ene-h/PE2/Production_Files/PE2BOM.xls

Comment | Designator | Footprint
C2977719 miniUSBb | J1 | PE2:JLC_MINI-USB-SMD
C3008585 bootselSW | U1 | PE2:JLC_SW-SMD
STM32F446RCT6 | U3 | PE2:STM32F446RCT6
DM-OLED096-636 | U4 | PE2:MODULE_DM-OLED096-636
C603505 NCP115ASN330T2G LDO | U2 | PE2:SOT95P275X110-5N
100n | C1 C4 C6 C7 C8 C9 C11 C16 | Capacitor_SMD:C_0402_1005Metric
1uF | C2 C10 | Capacitor_SMD:C_0603_1608Metric
1uF Cer | C3 C12 | Capacitor_SMD:C_0603_1608Metric
10uF | C5 | Capacitor_SMD:C_0603_1608Metric
C382724 33pF | C13 C14 | Capacitor_SMD:C_0402_1005Metric
4.7uF | C15 | Capacitor_SMD:C_0603_1608Metric
C2286 PWR | D1 | LED_SMD:LED_0603_1608Metric
C2286 USR | D2 | LED_SMD:LED_0603_1608Metric
Conn_01x06 | J2 | Connector_PinHeader_2.54mm:PinHeader_1x06_P2.54mm_Horizontal
Conn_01x05 | J4 | Connector_PinHeader_2.54mm:PinHeader_1x05_P2.54mm_Horizontal
C163810 10k | R1 R2 | Resistor_SMD:R_0402_1005Metric
C226821 180R | R3 R4 | Resistor_SMD:R_0402_1005Metric
C455091 | SW1 SW5 SW9 SW11 SW15 SW19 | Button_Switch_THT:SW_PUSH_6mm_H5mm
SW_Push | SW2 SW3 SW4 SW6 SW7 SW8 SW12 SW13 SW14 SW16 SW17 SW18 | Kailh:Kailh_socket_PG1350_optional
C2985742 | SW10 | PE2:JLC_TactSW_Low-profile
C115962 8MHz | Y1 | Crystal:Crystal_SMD_5032-2Pin_5.0x3.2mm
