ene-h/PE2/Case_3D_Files/PCB-final.step

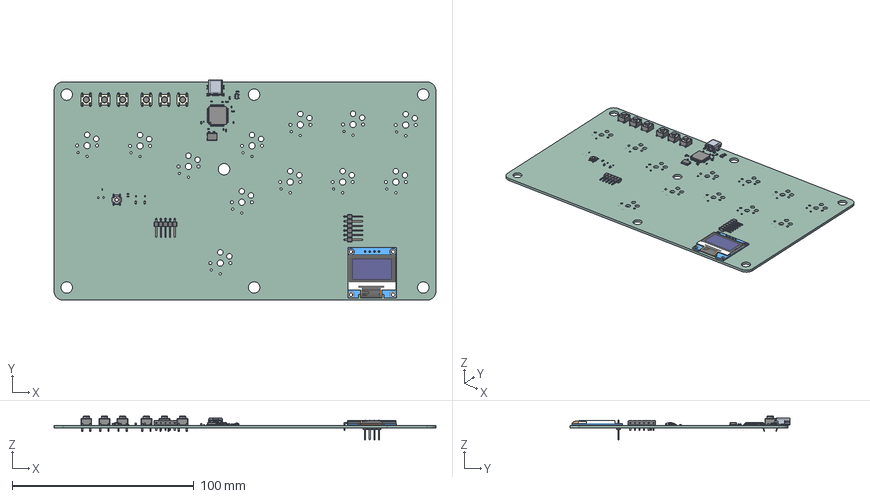
[picture p6: CAD file, 2024-06-01]
Case_3D_Files/PCB-final.step
210.0 x 121.2 x 13.1 mm
C_0402_1005Metric x 10
User Library-128x64I2COLEDDisplayAdafruit
LED_0603_1608Metric x 2
NCP551SN15T1G
C_0603_1608Metric x 6
R_0402_1005Metric x 4
PinHeader_1x06_P254mm_Horizontal
TS-1187A-B-A-B
STM32G070RBT6
PinHeader_1x05_P254mm_Horizontal
PE2-for-review_PCB
