ene-h/PE2/KiCad_Project/Componenten/4pos_header_RIGHT_ANGLE/PH1RB-04-UA.STEP

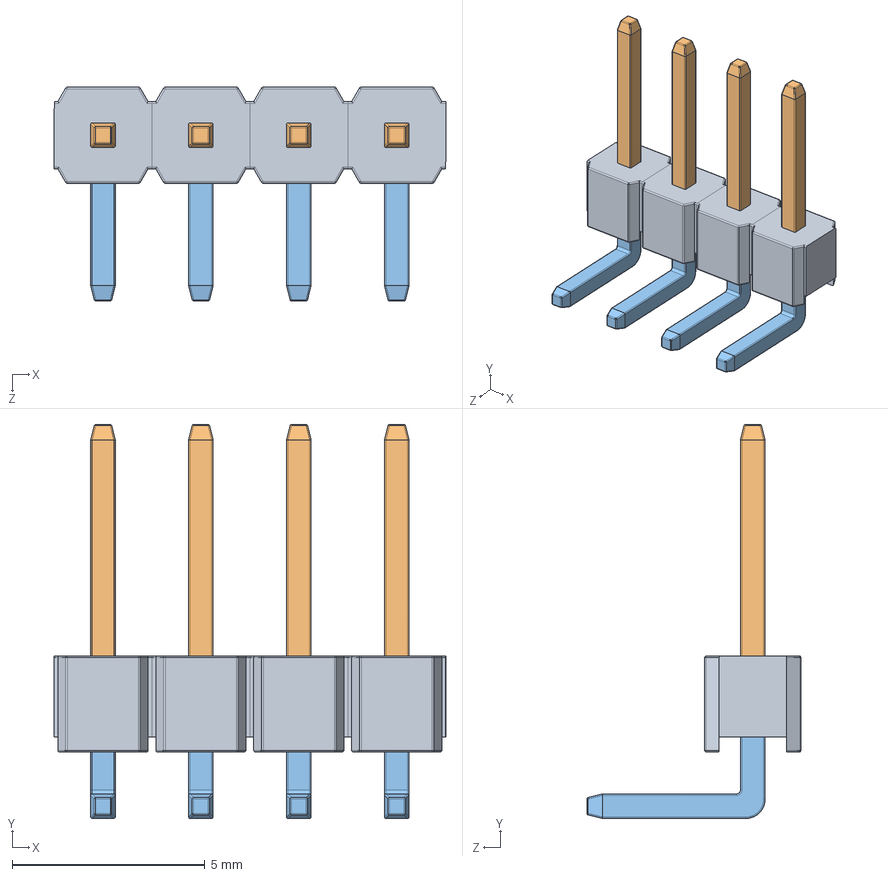
[picture p7: CAD file, 2024-06-01]
KiCad_Project/Componenten/4pos_header_RIGHT_ANGLE/PH1RB-04-UA.STEP
10.2 x 10.2 x 5.55 mm
