ene-h/PE2/KiCad_Project/Componenten/AA_8_000MALV_T/XTAL_AA-8_000MALV-T_TXC.step

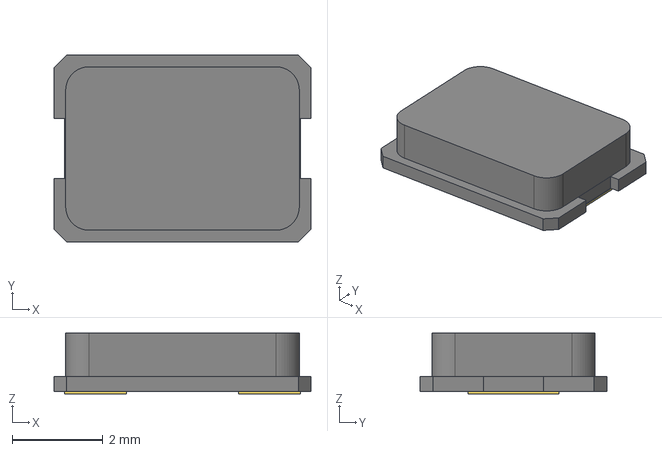
[picture p8: CAD file, 2024-06-01]
KiCad_Project/Componenten/AA_8_000MALV_T/XTAL_AA-8_000MALV-T_TXC.step
5.67 x 4.12 x 1.35 mm
