ene-h/PE2/KiCad_Project/Componenten/Crystal/ECS-80-18-5PX-GM-TR/3D/ECS-80-18-5PX-GM-TR.stp

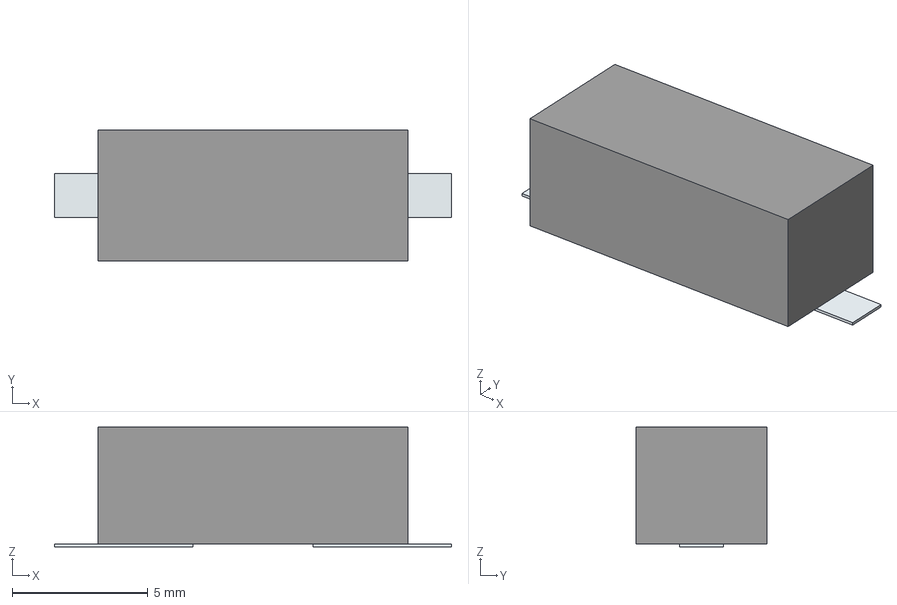
[picture p9: CAD file, 2024-06-01]
KiCad_Project/Componenten/Crystal/ECS-80-18-5PX-GM-TR/3D/ECS-80-18-5PX-GM-TR.stp
14.6 x 4.80 x 4.40 mm
Pins
