ene-h/PE2/KiCad_Project/Componenten/DM-OLED096-636--3DModel-STEP-56544.STEP

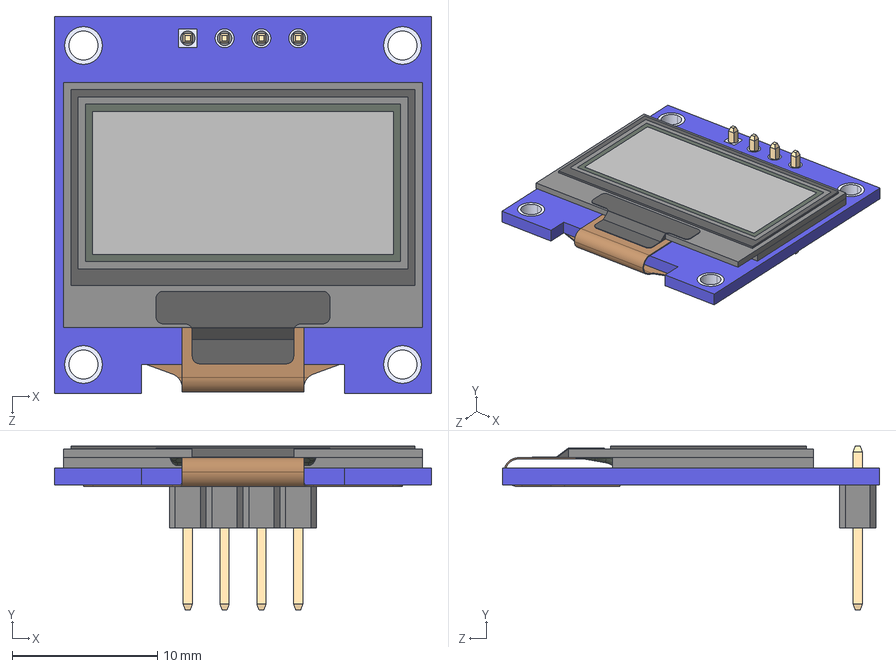
[picture p10: CAD file, 2024-06-01]
KiCad_Project/Componenten/DM-OLED096-636--3DModel-STEP-56544.STEP
26.0 x 11.3 x 26.0 mm
DM-OLED096-636_Module
DM-OLED096-636_Panel
