ene-h/PE2/KiCad_Project/Componenten/DM-OLED096-636/oled-no-header.step

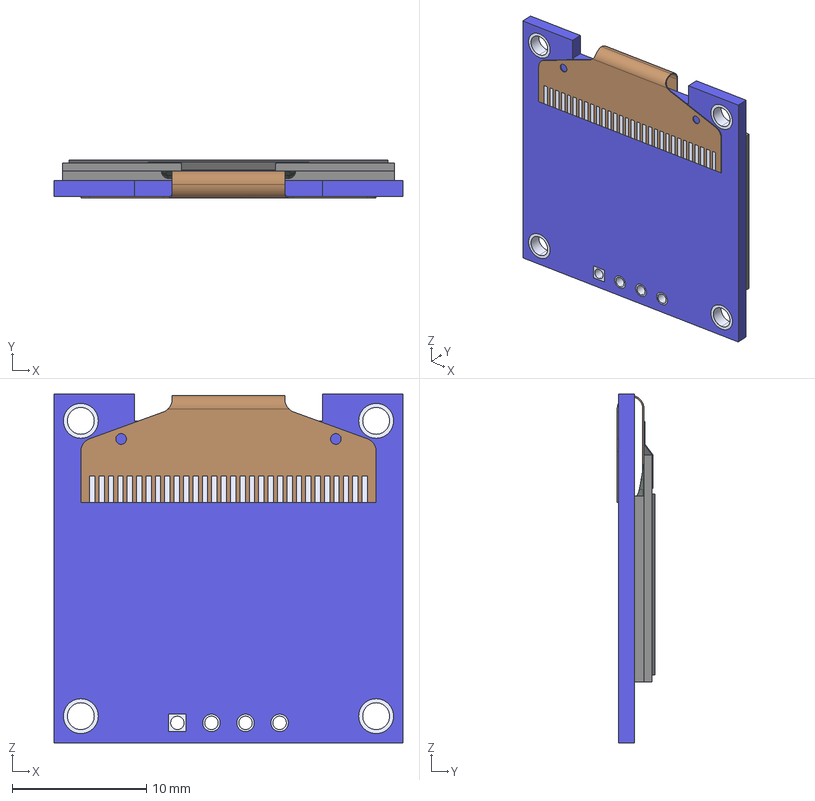
[picture p11: CAD file, 2024-06-01]
KiCad_Project/Componenten/DM-OLED096-636/oled-no-header.step
26.0 x 2.80 x 26.0 mm
DM-OLED096-636_Module009
DM-OLED096-636_Module010
DM-OLED096-636_Module011
DM-OLED096-636_Module012
DM-OLED096-636_Module013
DM-OLED096-636_Module014
DM-OLED096-636_Module015
DM-OLED096-636_Module016
DM-OLED096-636_Module017
DM-OLED096-636_Panel
DM-OLED096-636_Panel001
DM-OLED096-636_Panel002
DM-OLED096-636_Panel003
DM-OLED096-636_Panel004
DM-OLED096-636_Panel005
DM-OLED096-636_Panel006
DM-OLED096-636_Panel007
DM-OLED096-636_Panel008
DM-OLED096-636_Panel009
DM-OLED096-636_Panel010
DM-OLED096-636_Panel011
DM-OLED096-636_Panel012
DM-OLED096-636_Panel013
DM-OLED096-636_Panel014
DM-OLED096-636_Panel015
DM-OLED096-636_Panel016
DM-OLED096-636_Panel017
DM-OLED096-636_Panel018
DM-OLED096-636_Panel019
DM-OLED096-636_Panel020
DM-OLED096-636_Panel021
DM-OLED096-636_Panel022
DM-OLED096-636_Panel023
DM-OLED096-636_Panel024
DM-OLED096-636_Panel025
DM-OLED096-636_Panel026
DM-OLED096-636_Panel027
DM-OLED096-636_Panel028
DM-OLED096-636_Panel029
DM-OLED096-636_Panel030
DM-OLED096-636_Panel031
DM-OLED096-636_Panel032
DM-OLED096-636_Panel033
DM-OLED096-636_Panel034
DM-OLED096-636_Panel035
DM-OLED096-636_Panel036
DM-OLED096-636_Panel037
DM-OLED096-636_Panel038
DM-OLED096-636_Panel039
