ene-h/PE2/KiCad_Project/Componenten/NCP115ASN330T2G/NCP115ASN330T2G.step

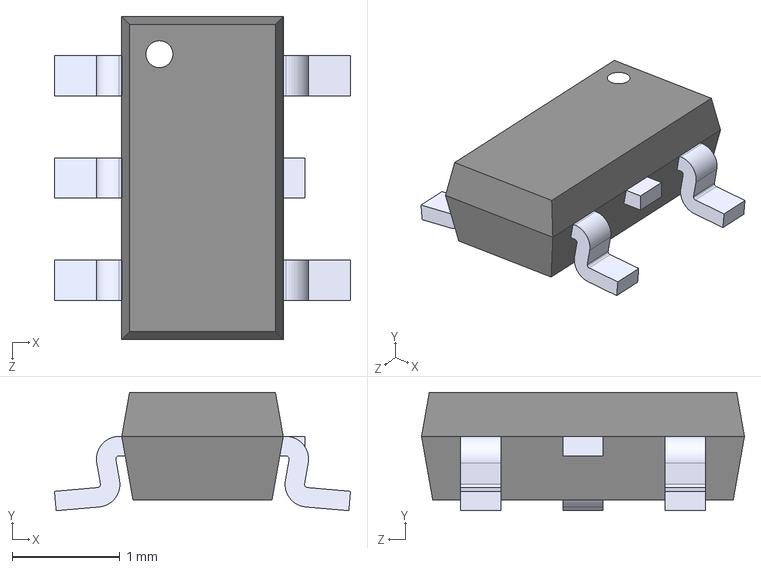
[picture p12: CAD file, 2024-06-01]
KiCad_Project/Componenten/NCP115ASN330T2G/NCP115ASN330T2G.step
2.75 x 1.10 x 3.00 mm
