ene-h/PE2/KiCad_Project/Componenten/STM32F446RCT6/STM32F446RCT6.step

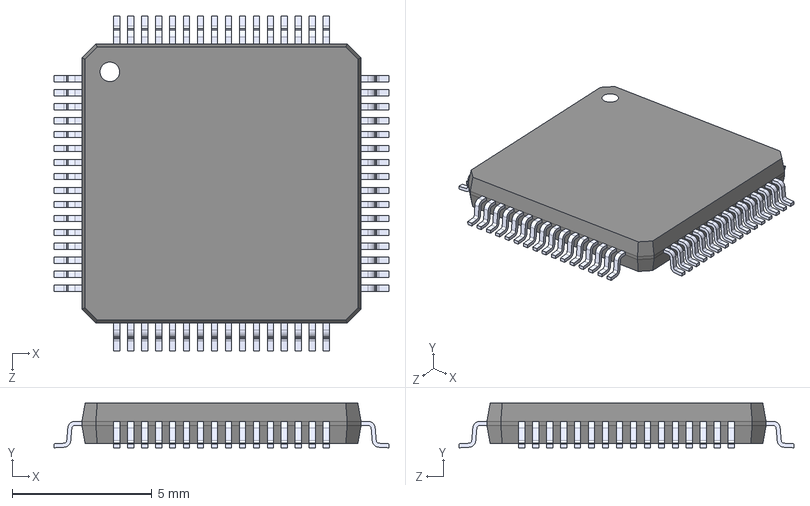
[picture p13: CAD file, 2024-06-01]
KiCad_Project/Componenten/STM32F446RCT6/STM32F446RCT6.step
12.0 x 1.60 x 12.0 mm
