ene-h/PE2/KiCad_Project/Componenten/TS-1187A-B-A-B/TS-1187A-B-A-B.step

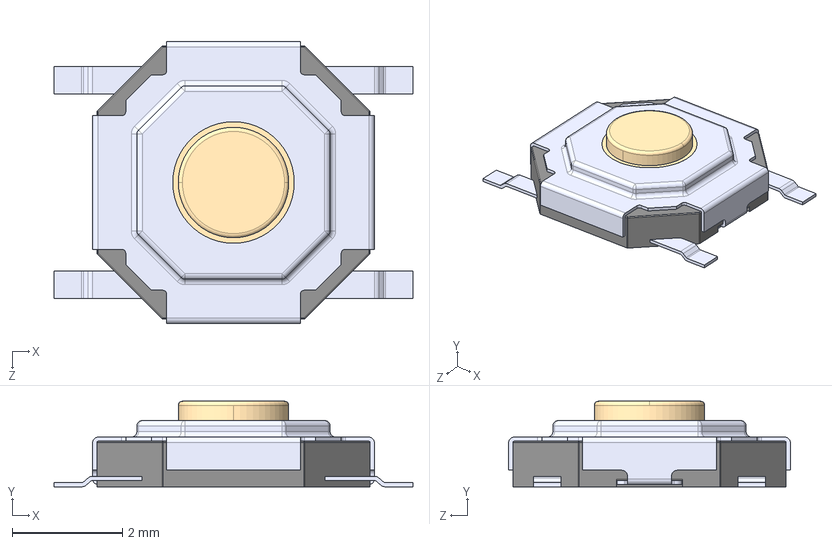
[picture p14: CAD file, 2024-06-01]
KiCad_Project/Componenten/TS-1187A-B-A-B/TS-1187A-B-A-B.step
6.50 x 1.55 x 5.10 mm
