ene-h/PE2/KiCad_Project/Componenten/usbC/USB4125-GF-A_REVA2.step

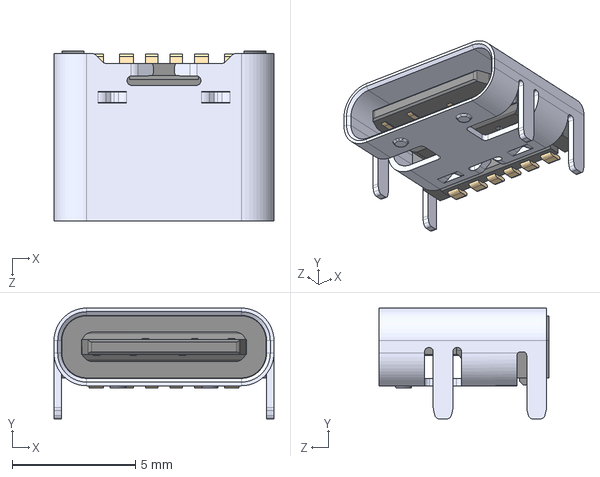
[picture p15: CAD file, 2024-06-01]
KiCad_Project/Componenten/usbC/USB4125-GF-A_REVA2.step
8.94 x 4.51 x 6.90 mm
