ene-h/PE2/KiCad_Project/Componenten/usbM/54-00019.step

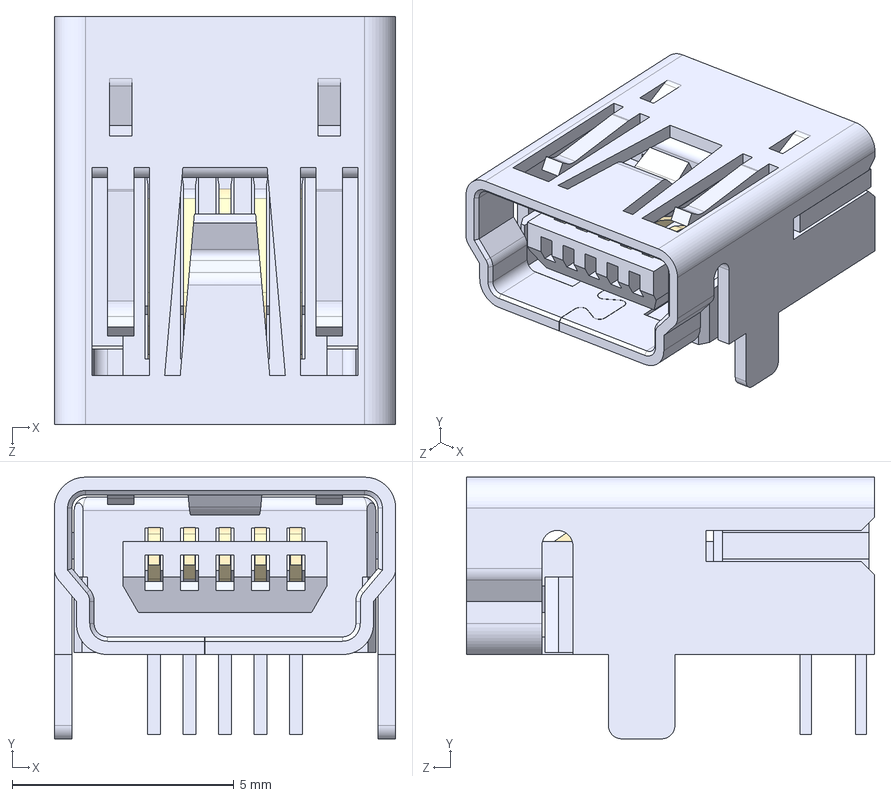
[picture p16: CAD file, 2024-06-01]
KiCad_Project/Componenten/usbM/54-00019.step
7.70 x 5.90 x 9.20 mm
54-00019_shell
54-00019_insulator
54-00019_pin5
54-00019_pin4
54-00019_pin3
54-00019_pin2
54-00019_pin1
