ene-h/PE2/KiCad_Project/Componenten/usbM2/WQ-1600514.stp

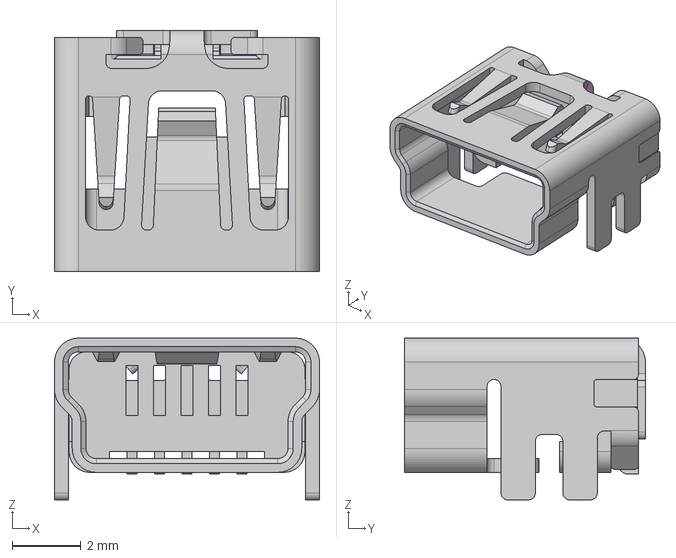
[picture p17: CAD file, 2024-06-01]
KiCad_Project/Componenten/usbM2/WQ-1600514.stp
7.70 x 7.00 x 4.70 mm
