ene-h/PE2/KiCad_Project/PE2-for-review.step

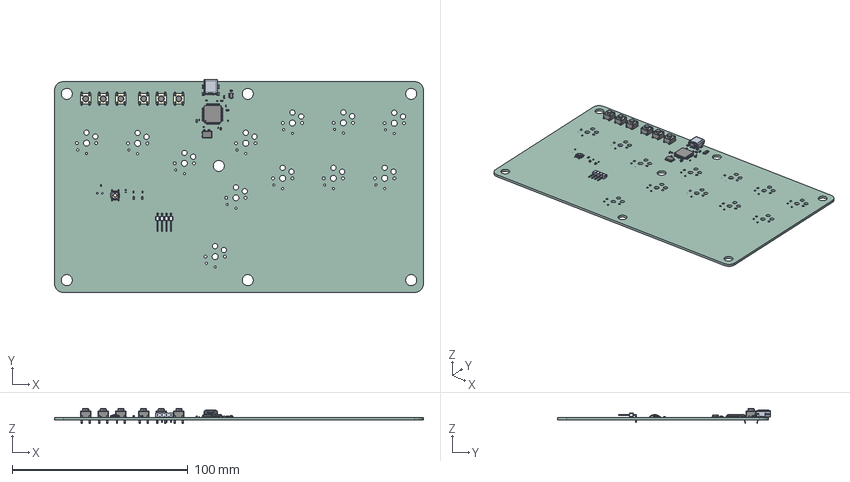
[picture p18: CAD file, 2024-06-01]
KiCad_Project/PE2-for-review.step
210.0 x 121.2 x 8.52 mm
C_0402_1005Metric x 10
LED_0603_1608Metric x 2
NCP551SN15T1G
C_0603_1608Metric x 6
R_0402_1005Metric x 4
TS-1187A-B-A-B
STM32G070RBT6
PH1RB-04-UA
PE2JLC_PCB
