ene-h/PE2/Case_3D_Files/Buttoncap.stl

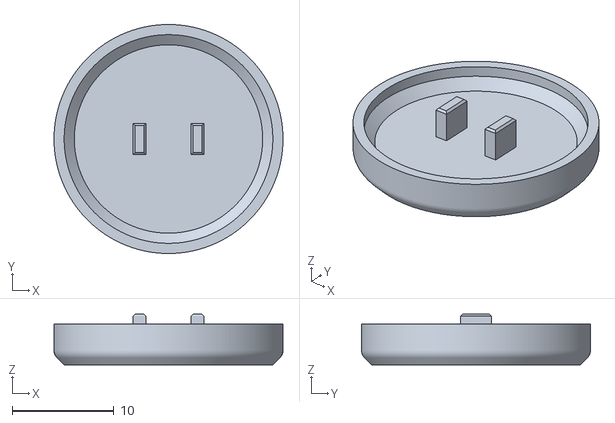
[picture p19: CAD file, 2024-06-01]
Case_3D_Files/Buttoncap.stl
22.5 x 22.5 x 5.00
