ene-h/PE2/KiCad_Project/Componenten/OSSD-128x64_1733874289.214.step

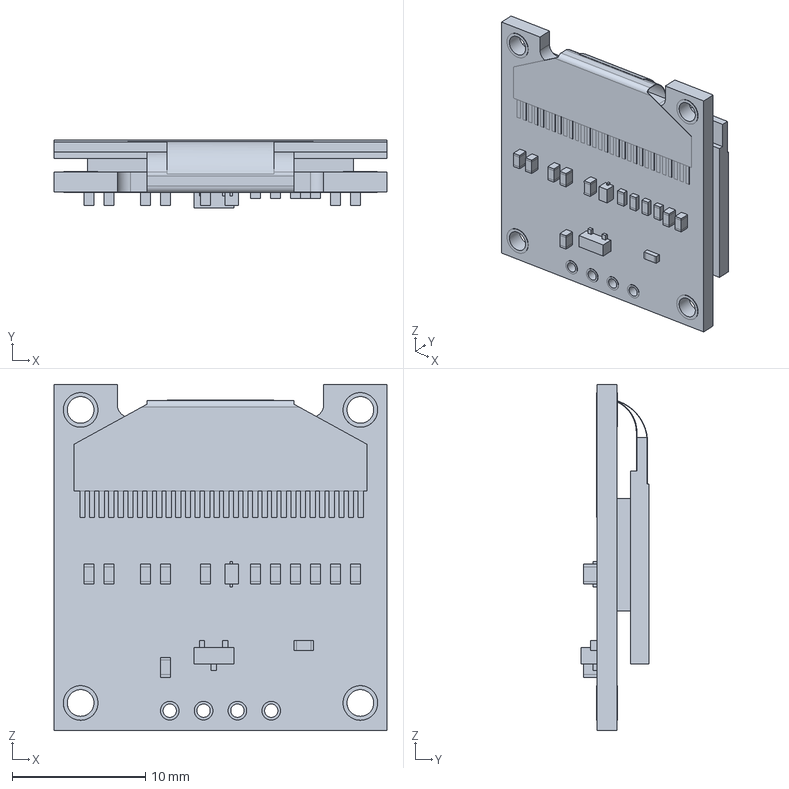
[picture p20: CAD file, 2024-06-01]
KiCad_Project/Componenten/OSSD-128x64_1733874289.214.step
25.0 x 5.10 x 26.0 mm
