ene-h/PE2/Case_3D_Files/ButtoncapBig.stl

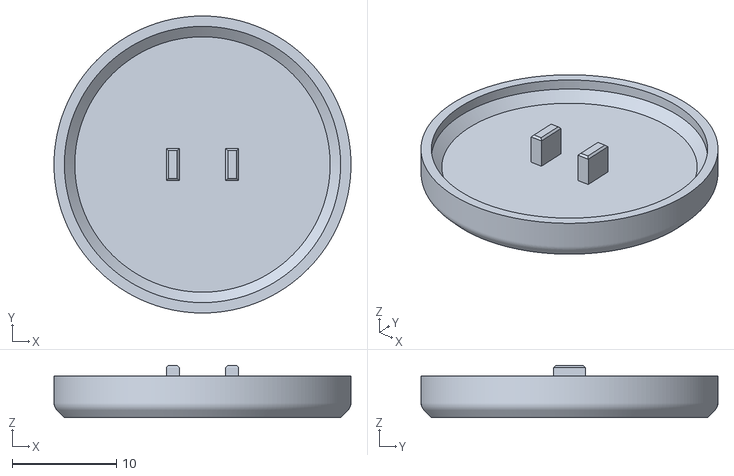
[picture p21: CAD file, 2024-06-01]
Case_3D_Files/ButtoncapBig.stl
28.5 x 28.5 x 5.00
