ene-h/PE2/KiCad_Project/Componenten/OLED 128x64.STP

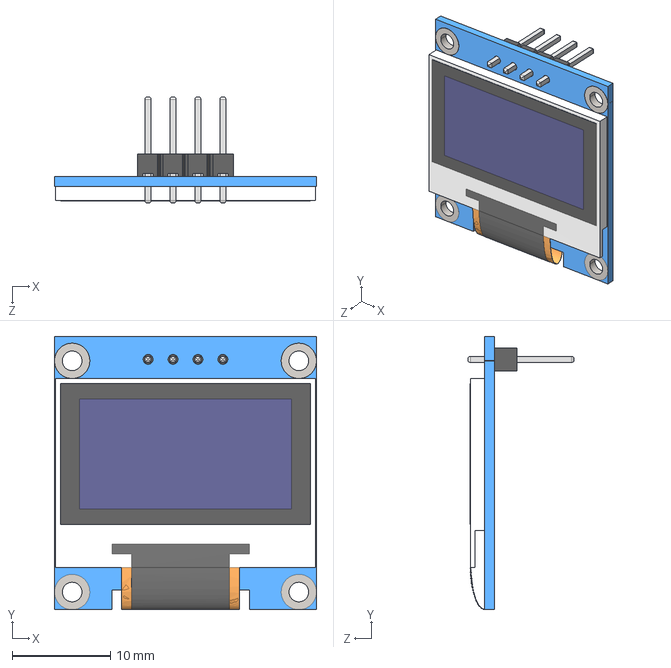
[picture p22: CAD file, 2024-06-01]
KiCad_Project/Componenten/OLED 128x64.STP
26.7 x 27.9 x 10.8 mm
