ene-h/PE2/Case_3D_Files/Bottom.stl

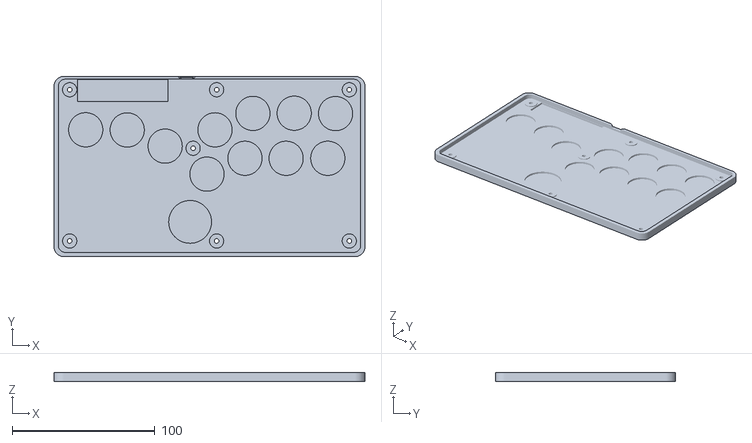
[picture p23: CAD file, 2024-06-01]
Case_3D_Files/Bottom.stl
218.0 x 126.4 x 6.20
