ene-h/PE2/KiCad_Project/Componenten/JLC_miniUSB-Step.stp

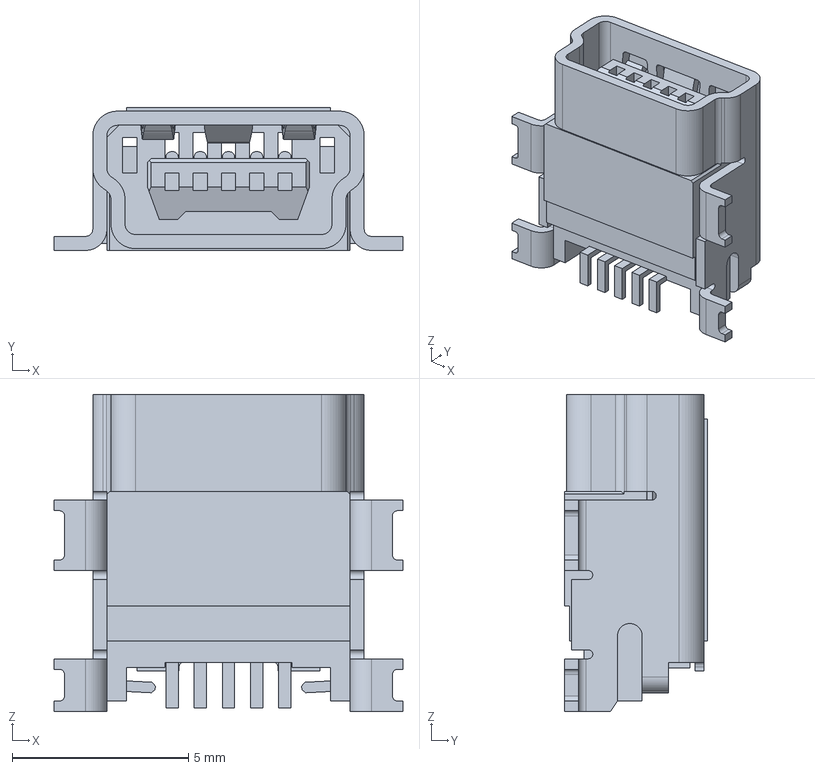
[picture p24: CAD file, 2024-06-01]
KiCad_Project/Componenten/JLC_miniUSB-Step.stp
9.90 x 4.05 x 9.00 mm
