ene-h/PE2/Case_3D_Files/Top.stl

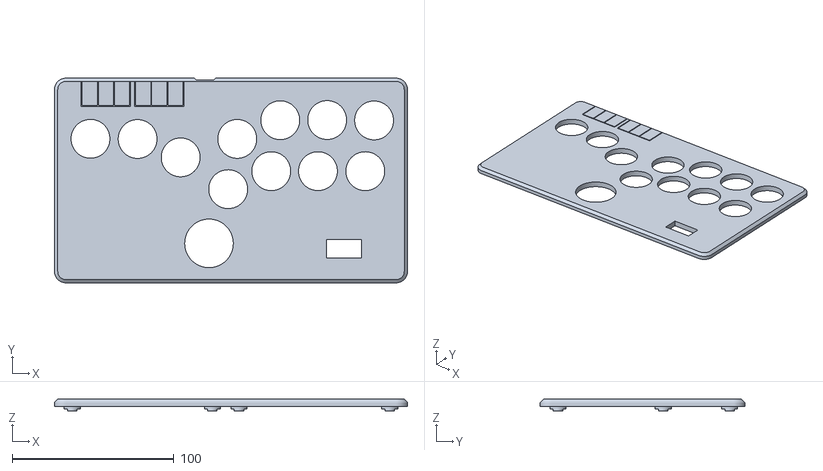
[picture p25: CAD file, 2024-06-01]
Case_3D_Files/Top.stl
218.0 x 126.4 x 7.20
