ene-h/PE2/(list of files, cad)

Other CAD files:
KiCad_Project/Componenten/tactswitch/1825910-6.step
