ene-h/PE2/KiCad_Project/PE2-for-review.kicad_pcb

## KiCad design KiCad_Project/PE2-for-review.kicad_pcb (2024-06-01)

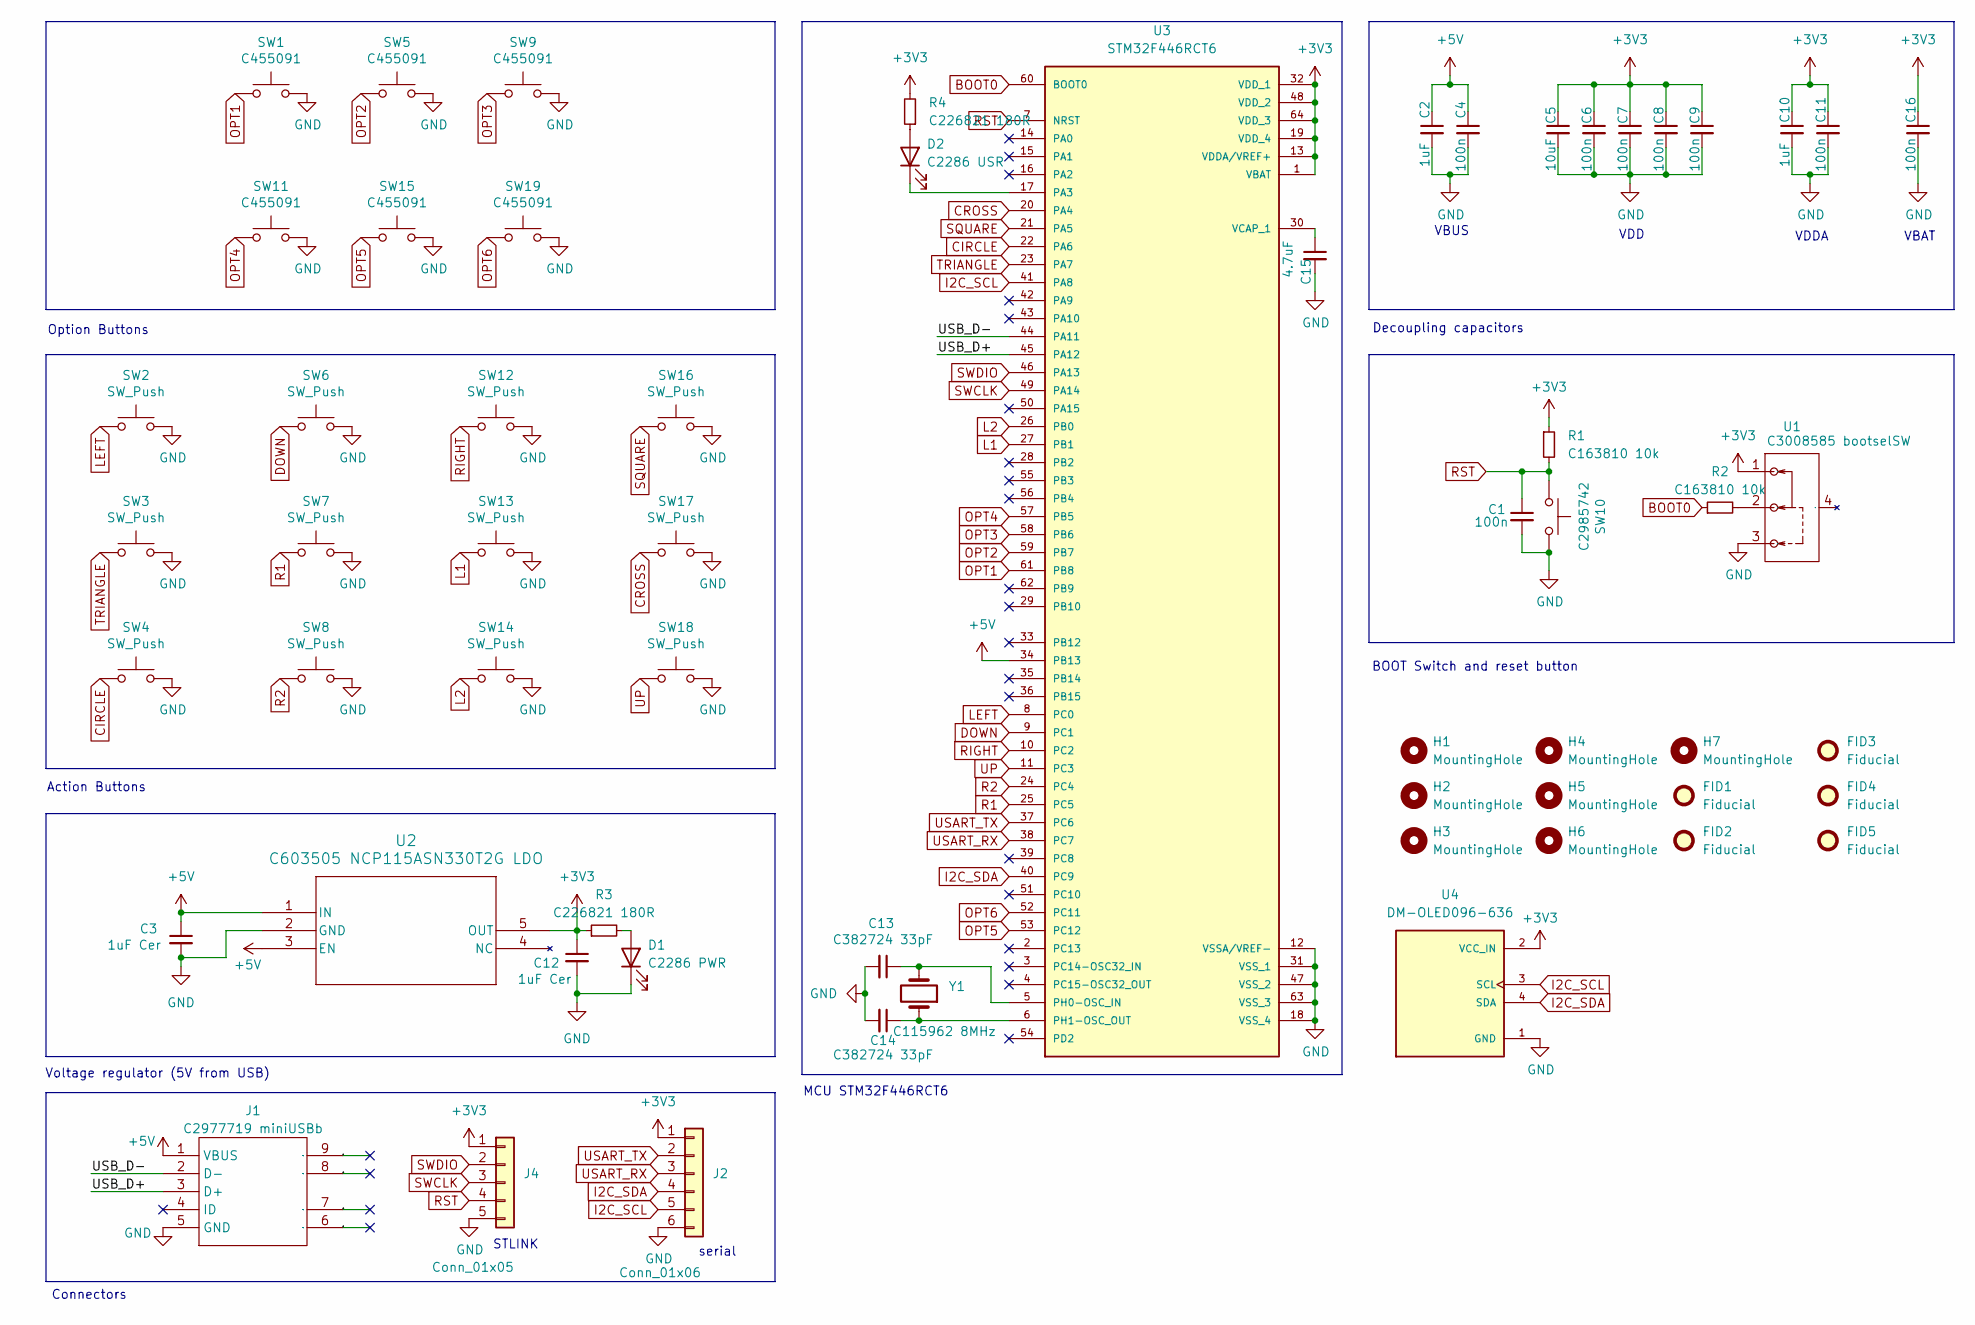
[picture p26: schematic PE2-for-review.kicad_sch]

Parts:
C1, C4, C6, C7, C8, C9, C11, C16: 100n; C_0402_1005Metric
C2, C10: 1uF; C_0603_1608Metric
C3, C12: 1uF Cer; C_0603_1608Metric
C5: 10uF; C_0603_1608Metric
C13, C14: C382724 33pF; C_0402_1005Metric
C15: 4.7uF; C_0603_1608Metric
D1: C2286 PWR; LED_0603_1608Metric
D2: C2286 USR; LED_0603_1608Metric
FID1, FID2, FID3: Fiducial; Fiducial_0.75mm_Mask2.25mm
FID4, FID5: Fiducial; Fiducial_0.5mm_Mask1mm
H1, H2, H3, H4, H5, H6, H7: MountingHole; MountingHole_6.3mm
J1: C2977719 miniUSBb; JLC_MINI-USB-SMD
J2: Conn_01x06; PinHeader_1x06_P2.54mm_Horizontal
J4: Conn_01x05; PinHeader_1x05_P2.54mm_Horizontal
R1, R2: C163810 10k; R_0402_1005Metric
R3, R4: C226821 180R; R_0402_1005Metric
SW1, SW5, SW9, SW11, SW15, SW19: C455091; SW_PUSH_6mm_H5mm
SW2, SW3, SW4, SW6, SW7, SW8, SW12, SW13, SW14, SW16, SW17, SW18: SW_Push; Kailh_socket_PG1350_optional
SW10: C2985742; JLC_TactSW_Low-profile
U1: C3008585 bootselSW; JLC_SW-SMD
U2: C603505 NCP115ASN330T2G LDO; SOT95P275X110-5N
U3: STM32F446RCT6
U4: DM-OLED096-636; MODULE_DM-OLED096-636; PARTREV 2018-09-10
Y1: C115962 8MHz; Crystal_SMD_5032-2Pin_5.0x3.2mm

Connections:
+3V3: C5.1, C6.1, C7.1, C8.1, C9.1, C10.1, C11.1, C12.1, C16.1, J2.1, J4.1, R1.1, R3.1, R4.2, U1.1, U2.5 (OUT), U3.1 (VBAT), U3.13 (VDDA/VREF+), U3.19 (VDD_4), U3.32 (VDD_1), U3.48 (VDD_2), U3.64 (VDD_3), U4.2 (VCC_IN)
+5V: C2.1, C3.1, C4.1, J1.1 (VBUS), U2.1 (IN), U2.3 (EN), U3.34 (PB13)
/UC1: J1.9 (EH)
/UC2: J1.8 (EH)
/UC3: J1.7 (EH)
/UC4: J1.6 (EH)
/USB_D+: J1.3 (D+), U3.45 (PA12)
/USB_D-: J1.2 (D-), U3.44 (PA11)
BOOT0: R2.1, U3.60 (BOOT0)
CIRCLE: SW4.1, U3.22 (PA6)
CROSS: SW17.1, U3.20 (PA4)
DOWN: SW6.1, U3.9 (PC1)
GND: C1.2, C2.2, C3.2, C4.2, C5.2, C6.2, C7.2, C8.2, C9.2, C10.2, C11.2, C12.2, C13.2, C14.2, C15.2, C16.2, D1.1 (K), J1.5 (GND), J2.6, J4.5, SW1.2, SW2.2, SW3.2, SW4.2, SW5.2, SW6.2, SW7.2, SW8.2, SW9.2, SW10.2, SW11.2, SW12.2, SW13.2, SW14.2, SW15.2, SW16.2, SW17.2, SW18.2, SW19.2, U1.3, U2.2 (GND), U3.12 (VSSA/VREF-), U3.18 (VSS_4), U3.31 (VSS_1), U3.47 (VSS_2), U3.63 (VSS_3), U4.1 (GND)
I2C_SCL: J2.5, U3.41 (PA8), U4.3 (SCL)
I2C_SDA: J2.4, U3.40 (PC9), U4.4 (SDA)
L1: SW13.1, U3.27 (PB1)
L2: SW14.1, U3.26 (PB0)
LEFT: SW2.1, U3.8 (PC0)
unnamed: D1.2 (A), R3.2
unnamed: D2.2 (A), R4.1
unnamed: D2.1 (K), U3.17 (PA3)
unnamed: R2.2, U1.2
unnamed: C13.1, U3.5 (PH0-OSC_IN), Y1.2
unnamed: C14.1, U3.6 (PH1-OSC_OUT), Y1.1
unnamed: C15.1, U3.30 (VCAP_1)
OPT1: SW1.1, U3.61 (PB8)
OPT2: SW5.1, U3.59 (PB7)
OPT3: SW9.1, U3.58 (PB6)
OPT4: SW11.1, U3.57 (PB5)
OPT5: SW15.1, U3.53 (PC12)
OPT6: SW19.1, U3.52 (PC11)
R1: SW7.1, U3.25 (PC5)
R2: SW8.1, U3.24 (PC4)
RIGHT: SW12.1, U3.10 (PC2)
RST: C1.1, J4.4, R1.2, SW10.1, U3.7 (NRST)
SQUARE: SW16.1, U3.21 (PA5)
SWCLK: J4.3, U3.49 (PA14)
SWDIO: J4.2, U3.46 (PA13)
TRIANGLE: SW3.1, U3.23 (PA7)
UP: SW18.1, U3.11 (PC3)
USART_RX: J2.3, U3.38 (PC7)
USART_TX: J2.2, U3.37 (PC6)

Notes on the sheet:
Voltage regulator (5V from USB)
MCU STM32F446RCT6
serial
BOOT Switch and reset button
STLINK
Connectors
VBAT
Decoupling capacitors
Option Buttons
VBUS
VDD
Action Buttons
VDDA

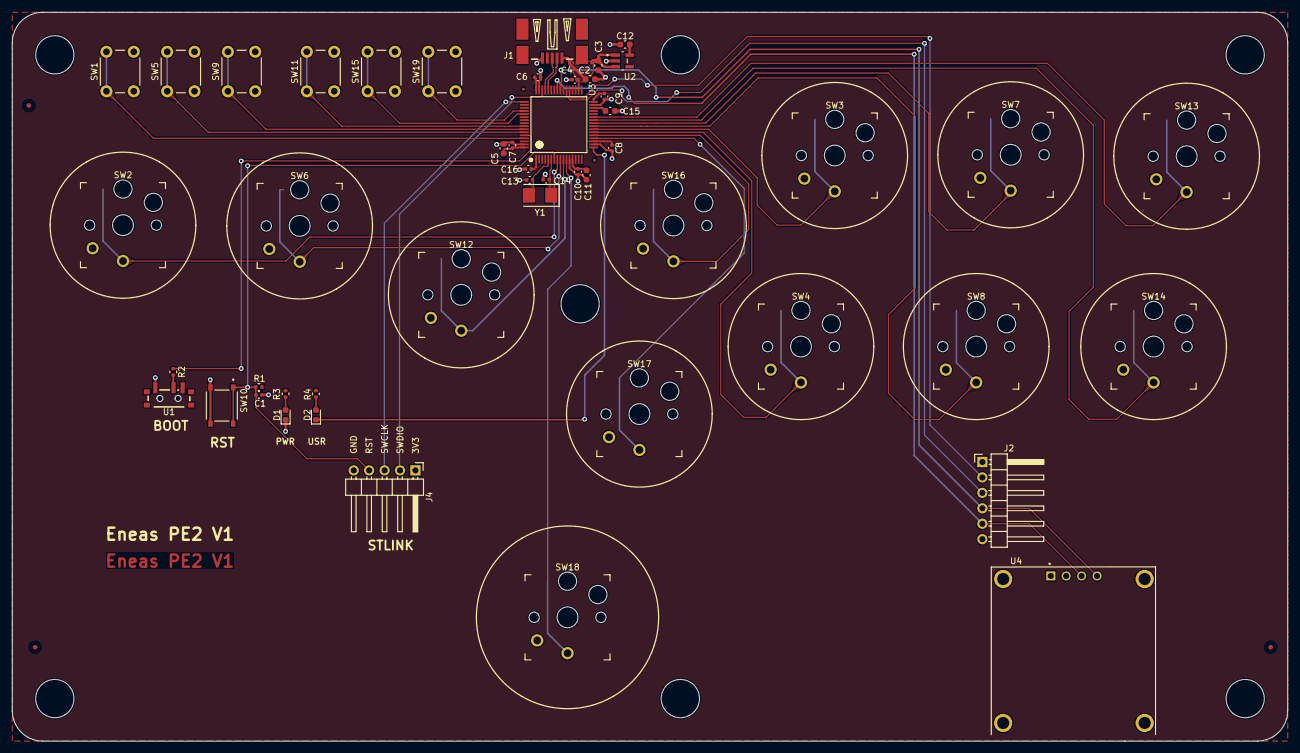
[picture p27: board PE2-for-review.kicad_pcb from above]

Board: 2 copper layers, 210.0 x 120.0 mm, 61 parts (0 on the bottom side), 38 nets.
