ene-h/PE2/CubeIDE_Project/keyboxEAZY/Core/Src/main.c

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
/* Includes ------------------------------------------------------------------*/
#include "main.h"
#include "usb_device.h"

/* USER CODE BEGIN Includes */
#include "usbd_hid.h"
#include "ssd1306.h"
/* USER CODE END Includes */

/* USER CODE BEGIN PD */
#define REPORT_SIZ 2*AXIS_NUM+2*BUTTONS_ENABLED+DPAD_ENABLED
/* USER CODE END PD */

CRC_HandleTypeDef hcrc;

I2C_HandleTypeDef hi2c3;

UART_HandleTypeDef huart6;

/* USER CODE BEGIN PV */

//volatile uint8_t data_ready = 0;

#if (AXIS_NUM > 0)
uint32_t filter_buf[AXIS_NUM][FILTER_WINDOW_SIZE];
#endif
uint8_t report_data[REPORT_SIZ];

uint8_t buttons_state[2];
uint8_t dpad_state;
extern const SSD1306_Font_t Font_7x10;
/* USER CODE END PV */

void SystemClock_Config(void);
static void MX_GPIO_Init(void);
static void MX_I2C3_Init(void);
static void MX_USART6_UART_Init(void);
static void MX_CRC_Init(void);
/* USER CODE BEGIN PFP */
uint16_t FilterWindow (uint32_t * p_buf, uint16_t new_val);

/* USER CODE END PFP */

/**
  * @brief  The application entry point.
  * @retval int
  */
int main(void)
{
  /* MCU Configuration--------------------------------------------------------*/

  /* Reset of all peripherals, Initializes the Flash interface and the Systick. */
  HAL_Init();

  /* Configure the system clock */
  SystemClock_Config();

  /* Initialize all configured peripherals */
  MX_GPIO_Init();
  MX_I2C3_Init();
  MX_USART6_UART_Init();
  MX_USB_DEVICE_Init();
  MX_CRC_Init();
  /* USER CODE BEGIN 2 */
  ssd1306_Init();
  HAL_GPIO_WritePin(LED_GPIO_Port, LED_Pin, 1);
  //ssd1306_Fill(White);
  ssd1306_SetCursor(0, 0);
  ssd1306_WriteString("Hello World!", Font_7x10, White);
  ssd1306_UpdateScreen();
  HAL_Delay(600);
  ssd1306_Fill(Black);
  ssd1306_UpdateScreen();

  /* USER CODE END 2 */

  /* Infinite loop */
  /* USER CODE BEGIN WHILE */
  while (1)
  {
    /* USER CODE END WHILE */

    /* USER CODE BEGIN 3 */

	  			GPIO_Poll((uint16_t*)&buttons_state);
	  			DPAD_Poll(&dpad_state);
#if (AXIS_NUM > 0)
	  			for (uint8_t i=0; i<AXIS_NUM; i++)
	  				report_data[i] = FilterWindow(filter_buf[i], ADC_data[i]);
#endif

#if (BUTTONS_ENABLED == 1)
				report_data[2 * AXIS_NUM] = buttons_state[0];
				report_data[2 * AXIS_NUM + 1] = buttons_state[1];
#endif
#if (DPAD_ENABLED == 1)
				report_data[2 * AXIS_NUM + 2 * BUTTONS_ENABLED] = dpad_state;

#endif
	  			uint8_t errrr = USBD_HID_SendReport(&hUsbDeviceFS, (uint8_t*) &report_data, (2 * AXIS_NUM + 2 * BUTTONS_ENABLED + 1)*sizeof(uint8_t));
	  			if (errrr == 3) {
	  				HAL_GPIO_WritePin(LED_GPIO_Port, LED_Pin, 0); //LED licht op wanneer de USB lib een error returnt (als de polling niet kan bijhouden)
	  				HAL_Delay(500);
				} else {
					HAL_GPIO_WritePin(LED_GPIO_Port, LED_Pin, 1);
				}

	  			DrawAll(buttons_state, &dpad_state);


  }
  /* USER CODE END 3 */
}

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
/* USER CODE BEGIN 4 */
void GPIO_Poll (uint16_t * p_button_state)
{
	*p_button_state = 0;
	*p_button_state |= HAL_GPIO_ReadPin(LP_GPIO_Port, LP_Pin);
	*p_button_state |= HAL_GPIO_ReadPin(MP_GPIO_Port, MP_Pin) << 1;
	*p_button_state |= HAL_GPIO_ReadPin(HP_GPIO_Port, HP_Pin) << 2;
	*p_button_state |= HAL_GPIO_ReadPin(EXP_GPIO_Port, EXP_Pin) << 3;
	*p_button_state |= HAL_GPIO_ReadPin(LK_GPIO_Port, LK_Pin) << 4;
	*p_button_state |= HAL_GPIO_ReadPin(MK_GPIO_Port, MK_Pin) << 5;
	*p_button_state |= HAL_GPIO_ReadPin(HK_GPIO_Port, HK_Pin) << 6;
	*p_button_state |= HAL_GPIO_ReadPin(EXK_GPIO_Port, EXK_Pin) << 7;
	*p_button_state |= HAL_GPIO_ReadPin(OPT1_GPIO_Port, OPT1_Pin) << 8;
	*p_button_state |= HAL_GPIO_ReadPin(OPT2_GPIO_Port, OPT2_Pin) << 9;
	*p_button_state |= HAL_GPIO_ReadPin(OPT3_GPIO_Port, OPT3_Pin) << 10;
	*p_button_state |= HAL_GPIO_ReadPin(OPT4_GPIO_Port, OPT4_Pin) << 11;
	*p_button_state |= HAL_GPIO_ReadPin(OPT5_GPIO_Port, OPT5_Pin) << 12;
	*p_button_state |= HAL_GPIO_ReadPin(OPT6_GPIO_Port, OPT6_Pin) << 13;
	*p_button_state ^= 0x3FFF;
	return;
}
void DPAD_Poll (uint8_t * p_dpad_state)
{
	*p_dpad_state 	= DPAD_NONE;
	uint8_t dpad_LR	= DPAD_NONE;
	uint8_t dpad_UD	= DPAD_NONE;
	uint8_t up 		= !(HAL_GPIO_ReadPin(UP_GPIO_Port, UP_Pin));
	uint8_t right 	= !(HAL_GPIO_ReadPin(RIGHT_GPIO_Port, RIGHT_Pin));
	uint8_t down 	= !(HAL_GPIO_ReadPin(DOWN_GPIO_Port, DOWN_Pin));
	uint8_t left 	= !(HAL_GPIO_ReadPin(LEFT_GPIO_Port, LEFT_Pin));

	//SOCD Cleaning: UP + DOWN moet UP worden, LEFT + RIGHT moet neutral worden

	if (down && (!up)) {
		dpad_UD	= DPAD_DOWN;
	}

	if (up) {
		dpad_UD	= DPAD_UP;
	}

	if (left && right) {
		dpad_LR = DPAD_NONE;
	} else if (left && (!right)) {
		dpad_LR = DPAD_LEFT;
	} else if ((!left) && right) {
		dpad_LR = DPAD_RIGHT;
	}

	if (dpad_LR != DPAD_NONE) {
		if (dpad_UD == DPAD_NONE) {
			*p_dpad_state = dpad_LR;	//cardinal LR
		} else {						//Non-cardinal
			if(dpad_UD == DPAD_UP) {
				if (dpad_LR == DPAD_RIGHT) {
					*p_dpad_state = DPAD_UPRIGHT;
				} else { //must be left
					*p_dpad_state = DPAD_UPLEFT;
				}
			} else { //must be down
				if (dpad_LR == DPAD_RIGHT) {
					*p_dpad_state = DPAD_DOWNRIGHT;
				} else { //must be left
					*p_dpad_state = DPAD_DOWNLEFT;
				}
			}
		}
	} else if (dpad_UD != DPAD_NONE) {
		*p_dpad_state = dpad_UD;		//cardinal UD
	}

	return;
}
void DrawAll(uint8_t* button_state,uint8_t* dpad_state) {
	ssd1306_Fill(Black);
	Draw_Buttons(button_state);
	Draw_DPAD(dpad_state);
	ssd1306_UpdateScreen();
	return;
}

void Draw_Buttons(uint8_t* button_state) {
	((*button_state & (0x1 << 0)) ? ssd1306_FillCircle : ssd1306_DrawCircle)(66, 16, 7, White); //LP
	((*button_state & (0x1 << 1)) ? ssd1306_FillCircle : ssd1306_DrawCircle)(82, 10, 7, White); //MP
	((*button_state & (0x1 << 2)) ? ssd1306_FillCircle : ssd1306_DrawCircle)(98, 10, 7, White); //HP
	((*button_state & (0x1 << 3)) ? ssd1306_FillCircle : ssd1306_DrawCircle)(114, 10, 7, White); //EXP
	((*button_state & (0x1 << 4)) ? ssd1306_FillCircle : ssd1306_DrawCircle)(63, 33, 7, White); //LK
	((*button_state & (0x1 << 5)) ? ssd1306_FillCircle : ssd1306_DrawCircle)(79, 28, 7, White); //MK
	((*button_state & (0x1 << 6)) ? ssd1306_FillCircle : ssd1306_DrawCircle)(95, 28, 7, White); //HK
	((*button_state & (0x1 << 7)) ? ssd1306_FillCircle : ssd1306_DrawCircle)(111, 28, 7, White); //EXK

//knoppen worden als volle of holle cirkels afgdrukt op basis van hun status (ingedrukt of niet)
	return;
}
void Draw_DPAD(uint8_t* dpad_state) {
	ssd1306_DrawCircle(56, 52, 9, White); //knoppen worden als volle of holle cirkels afgdrukt op basis van hun status (ingedrukt of niet) 
	ssd1306_DrawCircle(17, 16, 7, White); //(ook de SOCD cleaning wordt getoond doordat we de dpad_state gebruiken)
	ssd1306_DrawCircle(33, 16, 7, White);
	ssd1306_DrawCircle(48, 22, 7, White);
	switch (*dpad_state) {
		case DPAD_UP:
			ssd1306_FillCircle(56, 52, 9, White);
			break;
		case DPAD_UPRIGHT:
			ssd1306_FillCircle(56, 52, 9, White);
			ssd1306_FillCircle(48, 22, 7, White);
			break;
		case DPAD_RIGHT:
			ssd1306_FillCircle(48, 22, 7, White);
			break;
		case DPAD_DOWNRIGHT:
			ssd1306_FillCircle(33, 16, 7, White);
			ssd1306_FillCircle(48, 22, 7, White);
			break;
		case DPAD_DOWN:
			ssd1306_FillCircle(33, 16, 7, White);
			break;
		case DPAD_DOWNLEFT:
			ssd1306_FillCircle(17, 16, 7, White);
			ssd1306_FillCircle(33, 16, 7, White);
			break;
		case DPAD_LEFT:
			ssd1306_FillCircle(17, 16, 7, White);
			break;
		case DPAD_UPLEFT:
			ssd1306_FillCircle(56, 52, 9, White);
			ssd1306_FillCircle(17, 16, 7, White);
			break;
		default:
			break;
	}
	return;
}

uint16_t FilterWindow (uint32_t * p_buf, uint16_t new_val)
{
	uint16_t ret;

	p_buf[FILTER_WINDOW_SIZE-1] = new_val;

	for (uint8_t i=2; i<=FILTER_WINDOW_SIZE; i++)
	{
		p_buf[FILTER_WINDOW_SIZE-1] += p_buf[FILTER_WINDOW_SIZE - i];
	}

	p_buf[FILTER_WINDOW_SIZE-1] /= FILTER_WINDOW_SIZE;

	ret = p_buf[FILTER_WINDOW_SIZE-1];

	for (int i=0; i<FILTER_WINDOW_SIZE; i++)
	{
		p_buf[i-1] = p_buf[i];
	}

		return ret;
}
/* USER CODE END 4 */
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
