ene-h/PE2/CubeIDE_Project/keyboxEAZY/Core/Inc/hid.h

char ReportDescriptor[65] = {
    0x05, 0x01,                    // USAGE_PAGE (Generic Desktop)
    0x15, 0x00,                    // LOGICAL_MINIMUM (0)
    0x09, 0x04,                    // USAGE (Joystick)
    0xa1, 0x01,                    // COLLECTION (Application)
    0x05, 0x01,                    //   USAGE_PAGE (Generic Desktop)
    0x09, 0x01,                    //   USAGE (Pointer)
    0xa1, 0x00,                    //   COLLECTION (Physical)
    0x09, 0x30,                    //     USAGE (X)
    0x15, 0x00,                    //     LOGICAL_MINIMUM (0)
    0x26, 0x00, 0x10,              //     LOGICAL_MAXIMUM (4096)
    0x75, 0x10,                    //     REPORT_SIZE (16)
    0x95, 0x01,                    //     REPORT_COUNT (1)
    0x81, 0x02,                    //     INPUT (Data,Var,Abs)
    0xc0,                          //   END_COLLECTION
    0xa1, 0x00,                    //   COLLECTION (Physical)
    0x09, 0x33,                    //     USAGE (Rx)
    0x15, 0x00,                    //     LOGICAL_MINIMUM (0)
    0x26, 0x00, 0x10,              //     LOGICAL_MAXIMUM (4096)
    0x75, 0x10,                    //     REPORT_SIZE (16)
    0x95, 0x01,                    //     REPORT_COUNT (1)
    0x81, 0x02,                    //     INPUT (Data,Var,Abs)
    0xc0,                          //   END_COLLECTION
    0x05, 0x09,                    //   USAGE_PAGE (Button)
    0x19, 0x01,                    //   USAGE_MINIMUM (Button 1)
    0x29, 0x04,                    //   USAGE_MAXIMUM (Button 4)
    0x15, 0x00,                    //   LOGICAL_MINIMUM (0)
    0x25, 0x01,                    //   LOGICAL_MAXIMUM (1)
    0x75, 0x01,                    //   REPORT_SIZE (1)
    0x95, 0x04,                    //   REPORT_COUNT (4)
    0x55, 0x00,                    //   UNIT_EXPONENT (0)
    0x65, 0x00,                    //   UNIT (None)
    0x81, 0x02,                    //   INPUT (Data,Var,Abs)
    0xc0                           // END_COLLECTION
};
