ene-h/PE2/(commit log)

2024-06-01 KiCad and CubeIDE Project added
    [1825910-6.step, 54-00019.step, DM-OLED096-636--3DModel-STEP-56544.STEP, DM-OLED096-636.step, ECS-80-18-5PX-GM-TR.stp, JLC_miniUSB-Step.stp, NCP115ASN330T2G.step, OLED 128x64.STP]
2024-06-01 3D files for case added
    [Bottom.stl, Buttoncap.stl, ButtoncapBig.stl, PCB-final.step, Top.stl]
2024-06-01 Production files added
    [PE2-for-review-B_Cu.gbl, PE2-for-review-B_Mask.gbs, PE2-for-review-B_Paste.gbp, PE2-for-review-B_Silkscreen.gbo, PE2-for-review-Edge_Cuts.gm1, PE2-for-review-F_Cu.gtl, PE2-for-review-F_Mask.gts, PE2-for-review-F_Paste.gtp]
2024-06-01 updated comments in main + corrected I2C rate to actual value used on silicon
    [main.c]
2024-06-01 prettified schematic slightly + added schematic pdf
    [PE2-for-review.kicad_sch]
2024-06-01 added schematic and PCB PDFs
